min-jx-x/microprocessor-capstone/README.md

# LightQ — PDLC 단계 조광 AI 윈도우

> 시간대마다 정한 목표 밝기에 맞춰 창문 투명도를 스스로 바꾸고, 직사광이 들어오기 전에 미리 어둡게 하는 스마트 윈도우

**핵심 성과**

- **순천향대학교 캡스톤 경진대회 장려상**: 상용 컨트롤러 없이 PDLC 필름 2장, 변압기 2대, 릴레이로 3단계 조광 창문을 직접 구동해 학술제에서 실물 시연
- **AI 선제 차광**: 빛이 오르는 속도로 4초 뒤를 내다보는 결정트리(Pi에는 JSON 10KB)로, 단계를 바꿔야 하는 순간의 정확도를 규칙 48.3% → **74.9%**로 높임. 센서 잡음 3%에서도 시연 순서 200/200 성공
- **인터넷 없이 동작**: Pi 자체 핫스팟 + 휴대폰 앱, whisper.cpp 오프라인 음성 인식 + 의도 분류기(정확도 87.5%, LLM 하이브리드 93.8%)

순천향대학교 컴퓨터공학과 캡스톤디자인(마이크로프로세서) 팀 **라이트큐**의 프로젝트입니다.
PDLC(고분자 분산 액정) 조광 필름 2장을 겹쳐 투과율을 3단계로 나누고, Raspberry Pi 5가 실내 조도와 시각을 보고 단계를 자동으로 고릅니다. 필름 구동 전압(업체 안내 60~70V)에 맞춰 45V로 구동하며, 설정 하나로 100V를 더한 6단계 모드도 쓸 수 있습니다.

| 항목 | 내용 |
|---|---|
| 팀 | 강민재(팀장), 김대현, 곽재우 |
| 지도교수 | 양제파 |
| 연계 기업 | (주)유스바이오 |
| 기간 | 2026년 2학기 (완료) |
| 결과 | 순천향대학교 캡스톤 경진대회 **장려상** · 학술제에서 실물 시연 (Pi 핫스팟 + 휴대폰 앱·음성 명령) |

---

## 왜 만들었나

아침에 일어나기 힘든 이유 중 하나는 방이 너무 어둡거나, 반대로 갑자기 너무 밝아지기 때문입니다.
시중의 스마트 블라인드는 대부분 정해진 시각에 열고 닫거나, 밝기가 기준값을 넘으면 반응하는 방식이라 두 가지 한계가 있습니다.

- **목표 밝기를 따라가지 못합니다.** 열림과 닫힘 두 상태뿐이라 원하는 밝기에 맞춰 세밀하게 조절할 수 없습니다.
- **늦게 반응합니다.** 직사광선이 들어와 이미 눈이 부신 뒤에야 닫힙니다.

LightQ는 모터로 블라인드를 움직이는 대신 **필름의 투명도**를 바꿔서, 시간대별 목표 조도를 단계적으로 따라가고 밝기가 급하게 오를 때는 **미리** 어둡게 만듭니다.

## 주요 기능

- **3단계 투과율 제어**: 필름 2장 × (꺼짐 / 약 45V) 조합. `LIGHTQ_LEVELS=6`이면 100V를 더한 6단계
- **시간대별 목표 조도 추종**: 기상 준비, 아침, 주간 구간마다 목표 lux를 두고 실측 조도에 맞춰 단계 선택. 저녁·취침은 차광
- **기상 모드**: 기상 20분 전부터 목표 조도를 서서히 올려 자연광처럼 밝아짐
- **AI 선제 차광**: 최근 4초의 빛 변화로 4초 뒤 빛에 맞는 단계를 미리 고름 (결정트리)
- **오프라인 웹 대시보드**: Pi 자체 Wi-Fi 핫스팟으로 인터넷 없이 휴대폰에서 실시간 조도 확인, 단계·모드·판단 방식(규칙/AI) 변경, 기상 시각 설정
- **깜빡임 방지**: 데드밴드 + 같은 방향(어둡게/밝게) 판단 3회 연속 + 마지막 전환 후 5초 경과일 때만 전환
- **안전 장치**: 전압 전환 때 항상 전원 먼저 차단, 센서가 연속 10회 응답하지 않으면 모든 필름 전원 차단
- **하루 압축 재생**: 가상 시계로 하루를 2분에 재생해 시연
- **개인 선호 보정**: 사용자가 웹에서 직접 단계를 바꾸면 그 밝기를 선호로 배워 사용자별 목표 조도를 보정 (프로필별 저장)

## 시스템 구성

```mermaid
flowchart LR
    S[BH1750<br/>조도센서] -- I2C --> P[Raspberry Pi 5<br/>판단 · 웹서버]
    P -- GPIO --> R[릴레이 4개<br/>필름마다 두 선 차단]
    R --> F[PDLC 필름 A + B]
    T1[변압기 T1<br/>220V → 100V] --> T2[변압기 T2<br/>100V → 약 45V]
    T2 --> R
    F -. 투과광 .-> S
    U[휴대폰 웹] <-- Wi-Fi 핫스팟 --> P
```

### 필름 구동 원리

PDLC 필름은 교류 전압을 걸면 투명해지고, 전압이 없으면 빛을 흩뜨려 불투명해집니다.
상용 디밍 컨트롤러 대신 가정용 강압 변압기 2대로 두 가지 전압을 만들고, 릴레이로 필름마다 전압을 고릅니다.

- **T1**: 220V를 100V로 낮춥니다. 100V는 필름 구동 전압(60~70V)을 넘어서 필름에 직접 쓰지 않고, T2에 전기를 주는 데만 씁니다.
- **T2**: T1의 100V 출력을 다시 낮춰 약 45V를 만듭니다. 필름을 켜는 전압입니다.
- 필름마다 전원 릴레이 2개(PA·PA2, PB·PB2)를 같은 GPIO에 연결해 **두 선을 모두 끊습니다.** 꺼진 필름에는 전압이 남지 않습니다.

| 단계 | 필름 A | 필름 B | 상태 |
|:-:|:-:|:-:|---|
| 0 | 꺼짐 | 꺼짐 | 가장 어두움 (취침·저녁) |
| 1 | 45V | 꺼짐 | |
| 2 | 45V | 45V | 가장 밝음 |

> 실측값(`pi/data/lut.json`)을 넣으면 프로그램이 단계 순서를 밝기 순으로 자동 정렬합니다. 6단계 모드(`LIGHTQ_LEVELS=6`)에서는 100V/꺼짐, 100V/45V, 100V/100V가 추가되고, 필름마다 선택 릴레이 2개(SA1·SA2, SB1·SB2)로 45V와 100V를 고릅니다.

## 소프트웨어 구조

```mermaid
flowchart TD
    subgraph DEV["장치 계층 (같은 인터페이스)"]
        D1[실제: BH1750 · GPIO 릴레이]
        D2[가짜: SimSensor · SimRelays<br/>+ 가상 시계 · 바깥 빛]
    end
    L[제어 루프 loop.py<br/>1초 주기]
    J1[규칙 판단 decide.py]
    J2[AI 판단 policy.py<br/>결정트리 JSON]
    ST[안정화 · 안전 전환]
    DB[(SQLite 로그)]
    W[Flask 웹 app.py<br/>대시보드 · API]
    DEV --> L
    L --> J1 & J2
    J1 & J2 --> ST --> DEV
    L --> DB
    W <-- 명령 / 상태 --> L
```

- 센서·릴레이의 함수 모양을 먼저 정해, 노트북에서는 가짜 장치로, Pi에서는 실제 장치로 **같은 제어 코드**를 돌립니다.
- 웹은 명령만 보내고 릴레이는 제어 루프 한 곳에서만 움직입니다 (스레드 간 lock).
- 규칙과 AI는 같은 모양의 판단 함수라 웹에서 바로 바꿔 끼울 수 있습니다.

## 제어 흐름

```mermaid
flowchart TD
    A[조도 · 시각 측정<br/>1초 주기] --> F[중앙값 평활<br/>최근 5회, 같은 단계만]
    F --> B[목표 단계 계산<br/>AI 또는 규칙]
    B --> C{전환 조건?<br/>목표 ≠ 현재<br/>같은 방향 3회 연속 · 최소 5초 간격}
    C -- 아니오 --> A
    C -- 예 --> D[전원 릴레이 OFF]
    D --> E[전압 선택 릴레이 변경]
    E --> G[전원 릴레이 ON]
    G --> A
```

수동 버튼·음성 명령은 평활·전환 조건을 거치지 않고 바로 적용합니다.

전압을 바꿀 때는 항상 **전원 끄기 → 전압 선택 → 전원 켜기** 순서를 지킵니다. 필름에 전압이 걸린 상태로 전압 단자가 바뀌지 않게 하기 위해서입니다. 이 순서는 가능한 모든 단계 전환(3단계 9가지, 6단계 36가지)을 자동 테스트로 검증합니다.

### 규칙 판단

1. 입사광 추정: `실측 조도 / 현재 단계 투과율` (센서가 필름 안쪽에 있어 바깥 빛을 역산)
2. 필요 투과율: `목표 조도 / 입사광`
3. 필요 투과율에 가장 가까운 단계를 고르고, 현재 단계와 차이가 작으면(데드밴드 0.05) 유지

## AI 선제 차광

규칙 판단은 **지금** 빛만 보기 때문에 직사광이 다 올라온 뒤에야 반응합니다. AI는 빛이 오르는 속도를 보고 **4초 뒤 빛**에 맞는 단계를 미리 고릅니다.

| 항목 | 내용 |
|---|---|
| 입력 특징 (6개) | 필요 투과율(log), 최근 3구간 입사광 변화율, 현재 단계, 목표 조도 |
| 정답 | 시뮬레이터가 아는 4초 뒤 실제 입사광에 맞는 단계 |
| 학습 데이터 | 300일, 약 10만 행. 기상청 ASOS 일사량 곡선(서산·홍성·보령) + 합성 구름·직사광, 배속·기상 시각 무작위. 학습용 날은 센서 잡음 2%를 더한 복사본을 하나씩 추가(잡음 증강) |
| 입력 | 제어 루프와 같은 중앙값 평활(최근 5회)을 거친 조도 |
| 모델 | 결정트리 (깊이 8, 잎 221개) + 출력 데드밴드 (밝게 가자고 할 때 차이가 작으면 현재 단계 유지) |
| 검증 | 날짜 단위로 5일 중 1일을 떼어 처음 보는 날로 시험 |
| 실행 | 학습은 노트북(scikit-learn), Pi는 트리 구조 JSON(약 10KB)만 읽어 if문으로 추론 |

아래 수치는 11/1 센서 고정 후 실측 투과율(`pi/data/lut.json`), 주간 목표 320 lux, 중앙값 평활·잡음 증강을 넣어 다시 학습한 결과입니다. 시험용 날은 증강하지 않았습니다.

| 모델 시험 (정답 = 4초 뒤 빛 기준, 3단계, 실측 투과율) | 규칙 | AI |
|---|---|---|
| **바꿔야 할 때** (정답이 지금 단계와 다른 순간) | 48.3% | **74.9%** |
| 빛이 오르는 구간 | 81.6% | 93.4% |
| 전체 | 89.3% | 92.4% |

정답은 0단계 65%, 1단계 12%, 2단계 23%이고, "지금 단계 유지"만 해도 전체 정확도가 81.7%입니다. 그래서 단계를 바꿔야 하는 순간만 본 정확도를 주 지표로 씁니다. 중앙값 평활은 입력을 약 2초 늦게 만들어 4초 뒤 빛을 맞히는 정확도를 조금 낮추지만, 잡음에 흔들리지 않게 합니다([정량 평가](#정량-평가) 3).

### 왜 결정트리인가 (`python -m pi.ai.compare_models`)

같은 데이터·같은 시험 날짜로 다른 모델과 비교했습니다. 결과는 `pi/data/ai_report.json`에 저장되고, 웹 대시보드의 **AI 설명** 페이지(`/ai`)에서 그래프와 함께 보입니다.

| 모델 (실측 투과율) | 바꿔야 할 때 | Pi에 올리는 방법 |
|---|---|---|
| 규칙 (기준선) | 48.3% | - |
| **결정트리 (깊이 8, 현재)** | **74.9%** | JSON 10KB, if문 몇 번 |
| 로지스틱 회귀 | 70.7% | 가중치 몇 개 |
| 랜덤포레스트 100그루 | 76.7% | 16MB, scikit-learn 필요 |
| 그래디언트 부스팅 | 76.3% | 391KB, scikit-learn 필요 |
| 신경망 (MLP 32×32) | 76.3% | 행렬 곱 구현 필요 |

- **복잡한 모델과 차이가 2%p 안**(76.3~76.7%)인데, 결정트리는 Pi에 파일 하나로 올라가고 판단 근거(지나온 질문 경로)를 그대로 보여 줄 수 있습니다.
- **깊이 8**: 깊이 8에서 74.9%, 16까지 깊게 해도 75.0%로 거의 같은데 잎(규칙 수)은 221 → 1131개로 늘어납니다.
- **특징**: 빛 변화율 3개를 빼면 74.9% → 64.0%로 떨어집니다. AI가 규칙보다 나은 이유가 "빛이 오르는 속도"라는 뜻입니다.
- **4초 앞**: 안정화가 같은 판단 3번 연속을 요구해서 반응이 늦어지는데, 4초 앞을 보면 이 지연이 메워집니다. 4초는 **가정값 시뮬레이션**(실측 전)에서 직사광 눈부심이 1초 앞 1.8초, 4초 앞 0.5초, 8초 앞 10.8초로 가장 적어 정했습니다(규칙 2.1초). 실측 투과율에서는 직사광 장면에서 규칙·AI 모두 처음부터 0단계라 이 비교로는 차이가 나지 않습니다([정량 평가](#정량-평가) 4).

웹의 AI 설명 페이지에는 **지금 AI가 왜 이 단계를 골랐는지**(입력 6개, 트리가 지나온 질문, 규칙 답, 안정화 진행)도 1초마다 보여 줍니다.

일사량 환산은 `tools/convert_kma_radiation.py`를 따릅니다. 기상청 일사량(1시간 누적, MJ/m²)을 평균 일사강도(W/m²)로 바꾸고 자연광 발광효율 약 116 lm/W를 곱합니다. 학습에는 곡선의 모양만 쓰고, 크기는 시연 조명 수준으로 맞춥니다.

## 개인 선호 보정

AI(결정트리)는 **목표에 어떻게 빨리 맞출지**를 정하는 공통 모델이고, 선호 보정은 **목표를 얼마로 할지**를 사람마다 맞춥니다.

| 항목 | 내용 |
|---|---|
| 학습 신호 | 사용자가 단계를 직접 바꾼 뒤 3초 동안 잰 실내 조도(중앙값) = 그 사람이 원하는 밝기 |
| 학습 방식 | 시간대(아침·주간)별 보정값 ← 0.7 × 보정값 + 0.3 × (선호 조도 / 기본 목표 − 1), ±30% 제한 |
| 사용자 | 웹에서 프로필 선택·추가, `pi/data/preferences.json`에 저장 (재부팅해도 유지) |
| 사전 학습 | 필요 없음. 사용하면서 배우는 온라인 학습 |

선호가 다른 가상 사용자 3명(주간 선호 650 / 520 / 380 lux)을 날씨 10가지로 2주씩 돌려 검증했습니다 (`python -m pi.ai.eval_preference`). 아래 결과는 **6단계 구성 기준**입니다.

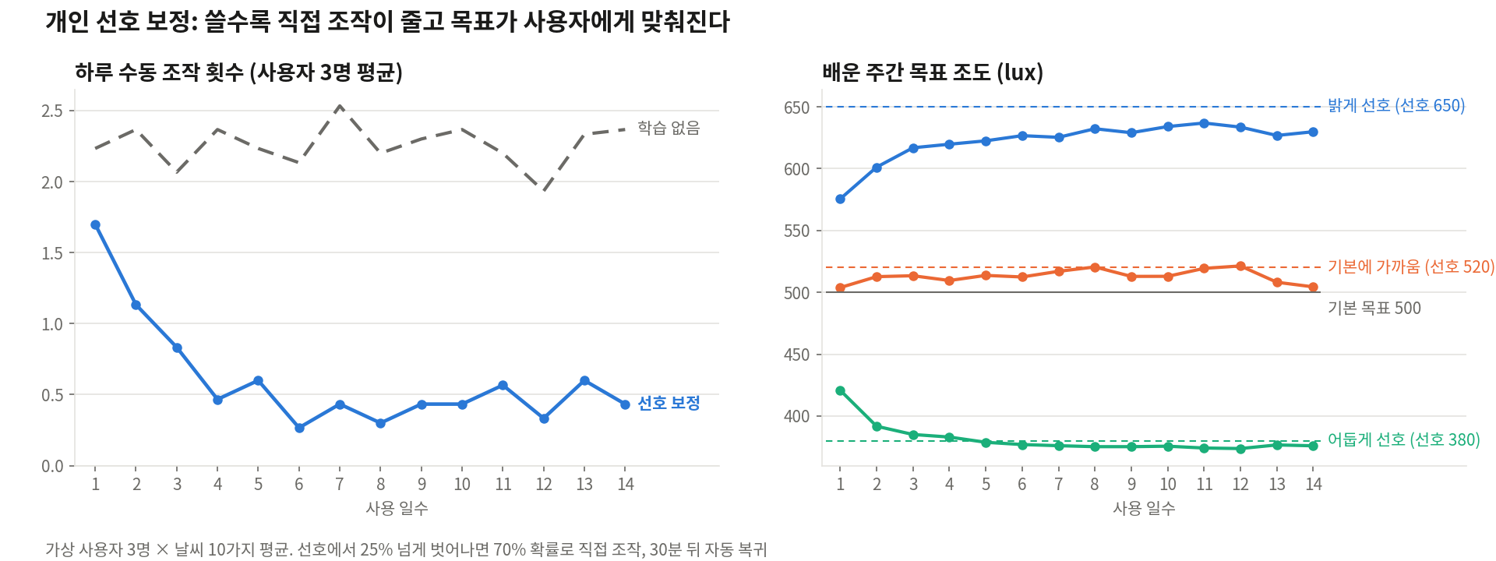
[picture p1: docs/archive/six-level/preference_learning.png]
선호 보정 (6단계)


| 지표 (마지막 7일 평균, 6단계) | 학습 없음 | 선호 보정 |
|---|---|---|
| 하루 수동 조작 횟수 (3명 평균) | 2.24회 | **0.44회** |
| 배운 주간 목표 (밝게 / 기본 근처 / 어둡게 선호) | 500 / 500 / 500 | **630 / 504 / 376** |

- 선호가 기본값과 비슷한 사용자는 원래 조작이 적어 차이가 거의 없습니다 (0.36 → 0.49회, 오차 범위).
- 가상 사용자 행동(25% 넘게 벗어나면 70% 확률로 조작)은 가정입니다.
- **3단계에서는 같은 시뮬레이션으로 효과가 나오지 않습니다.** 가장 밝은 단계(45V/45V)의 가정 투과율이 낮아 한낮에도 실내가 약 330~490 lux로 주간 목표(500 lux)에 못 미치고, 가상 사용자가 더 밝게 하고 싶어도 이미 가장 밝은 단계라 조작할 일이 없습니다(수동 조작 0회). (가정값 기준. 11/1 실측 투과율·주간 목표 320 lux로는 아직 다시 검증하지 않았습니다.)

## 음성 명령 (하이브리드)

휴대폰 앱의 음성 탭에서 "너무 밝아", "2단계로", "자동으로" 같은 문장으로 단계를 바꿉니다. 판단은 Pi가 하고, 웹 단계 버튼과 같은 경로(`set_manual`)로 적용됩니다.

휴대폰으로 `/`에 들어오면 앱 화면 `/app#home`으로 넘어갑니다(`/?full=1`이면 그 탭에서는 계속 대시보드). 휴대폰 판별은 "터치가 주 입력이고 화면 짧은 변이 700px 이하"라서 폰을 가로로 돌려도 앱이고, 노트북은 창을 좁혀도, 아이패드는 대시보드입니다. **앱과 음성 명령은 휴대폰 전용**이라 노트북 대시보드에는 음성 카드와 앱 링크가 없고, 노트북으로 `/app`·`/voice`를 열면 대시보드로 돌아갑니다(노트북에서 미리 보려면 크롬 F12 → 기기 모드에서 iPhone 선택). 아래 탭 바로 홈 / 음성(가운데 원형 마이크) / 설정을 오가며, 탭은 주소 해시(`#home` 등)로 바꿔 페이지를 다시 읽지 않습니다. 예전 주소 `/voice`는 `/app#voice`로 넘어갑니다. 녹음 코드는 `pi/static/voice-rec.js`.

- 홈: 실내 조도, 단계마다 뿌연 정도가 다른 창문 그림, 0/1/2 단계 버튼, 자동 제어 스위치, "AI가 조절 중 · 목표 320 lux". 수동일 때 "자동으로 돌아가기"
- 음성: 누르고 말하기, 예시 문장 4개, 접힌 "글자로 입력"
- 설정: 기상 시간, 선호 밝기(사용자 선택·추가·초기화), 수동 조절 학습, 음성도 학습
- 시연 잠금: `LIGHTQ_DEMO_LOCK=1`로 서버를 켜면 선호 밝기(사용자 선택·추가·초기화)와 학습 스위치 두 개를 바꾸는 API가 403("시연 중에는 잠겨 있어요")을 돌려줍니다. 기상 시간과 단계·자동 전환은 그대로 됩니다. 앱 설정 탭은 해당 조작을 끄고 안내를 띄우며, 대시보드는 잠금 상태만 표시합니다(해제는 환경변수를 빼고 다시 시작)

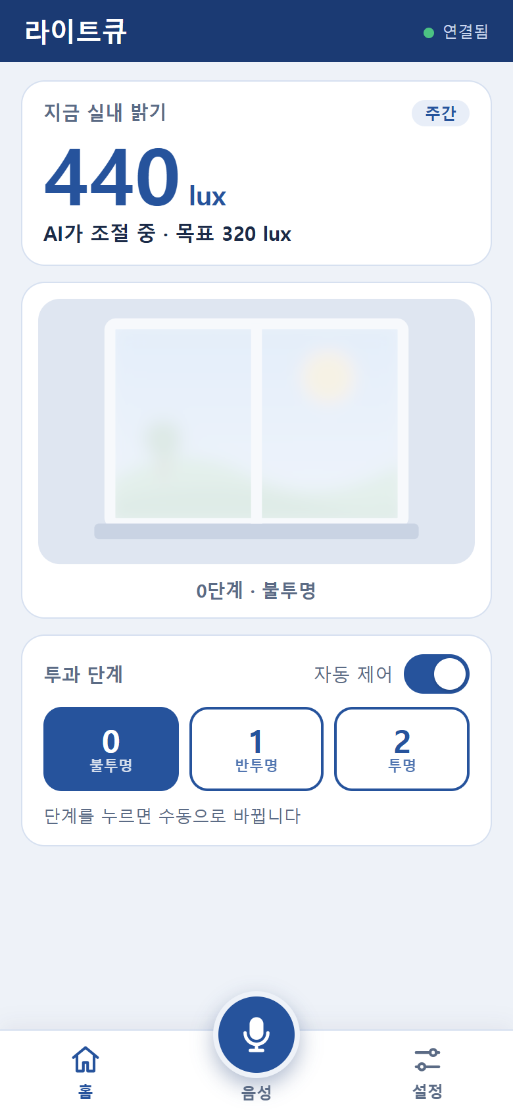
[picture p2: docs/images/app-home.png]
앱 홈 탭
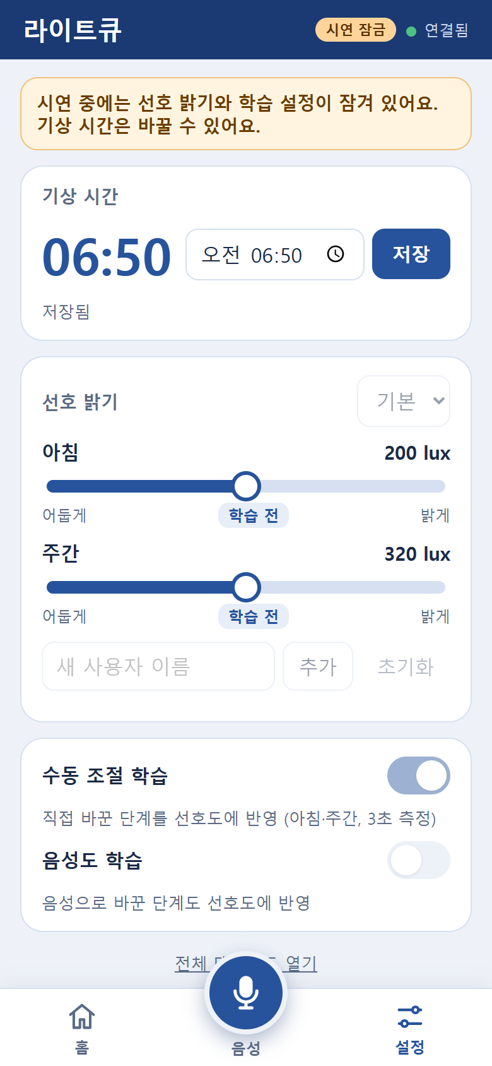
[picture p3: docs/images/app-settings-locked.png]
앱 설정 탭 (시연 잠금)
 앱 음성 탭 앱 설정 탭 

| 입력 | 방법 |
|---|---|
| 휴대폰 (권장) | 앱 음성 탭의 마이크 버튼(누르고 있는 동안 녹음) → Pi의 **whisper.cpp가 인터넷 없이** 글자로 변환. 브라우저 규칙상 HTTPS에서만 마이크가 열려서 `https://10.42.0.1:5443`(자체 서명 인증서, 처음 한 번 경고 → 계속)으로 접속 |
| 휴대폰 (예비) | 맨 아래 "글자로 입력"을 눌러 펼친 입력칸 + 키보드 마이크(받아쓰기). http(`10.42.0.1:5000`)에서도 되고 설정 없이 여러 대 동시 사용 가능. http로 들어오면 마이크용 HTTPS 주소를 안내 |
| whisper 서버가 없을 때 | 마이크 버튼은 브라우저 음성 인식(Web Speech, 대개 인터넷 필요)으로 동작 |

```
음성 → (웹에서 16kHz WAV로 녹음) → Pi whisper.cpp 서버(127.0.0.1:8178, base 모델) → 글자 → 아래 의도 판단
```

- 설치: `bash deploy/setup_whisper.sh` (Pi, 인터넷 필요한 건 설치 때 한 번), 인증서: `bash deploy/make_cert.sh`
- 소리가 거의 없으면 보내지 않고, Whisper가 지어내는 `[음악]` 같은 표기는 지움. 잡음에 Whisper가 인식 힌트(프롬프트)를 그대로 읊으면 "잘 안 들렸어요"로 처리
- 인식 힌트는 문장 없이 어휘만 둠("라이트큐 창문 밝기 단계 …"). 문장으로 두었을 때 노래만 틀어도 "잘 거야.", "1단계." 같은 힌트 문장을 지어내 실제로 단계가 바뀌었음. 어휘만 둔 뒤에도 노래에서 "사생활"(privacy 0.82)을 지어내 그 단어도 뺌
- 잡음 판정: whisper 응답(`verbose_json`)의 구간별 말 없음 확률 > 0.6 또는 평균 logprob < −0.4이면 그 구간을 버림. 기준은 `LIGHTQ_STT_MAX_NO_SPEECH`, `LIGHTQ_STT_MIN_LOGPROB`로 바꿈
  - Pi 재측정: 실제 명령은 logprob −0.05 ~ −0.27, 노래에서 지어낸 "사생활"은 −0.436 → 기준을 −1.0에서 −0.4로 올림. 말 없음 확률은 모든 녹음에서 0.0이라 그 기준으로는 걸러지지 않음
- 녹음은 최대 8초. 8초가 지나면 자동으로 보내고 "8초가 지나 보냈어요"로 알림
- whisper.cpp(base 모델) 인식 시간·정확도: Pi에서 따로 재지 못했습니다 ([한계와 향후 과제](#한계와-향후-과제))
- 녹음 파일은 기본으로 저장하지 않음. 정확도 확인 때만 `LIGHTQ_VOICE_KEEP=20`으로 최근 20개를 `pi/data/voice_audio/`에 남김(`python -m pi.voice.stt_check 파일.wav`)

```
문장 → ① 의도 분류기 (Pi, 오프라인, 약 0.1ms)
          ├ 확신도 ≥ 0.6 → 바로 적용
          └ 낮음 / 모름 → ② LLM (Gemini, 키·인터넷 있을 때)
                              ├ JSON 검사 통과 → 적용 ("영화 볼 거야" → 0단계 같은 상황형 문장)
                              └ 실패 / 없음 → 확신도 ≥ 0.35면 분류기 답, 아니면 "다시 말해 주세요"
```

- 분류기: 글자 1~3개 묶음 TF-IDF + 로지스틱 회귀. 예문 `pi/data/voice_intents.csv`, 학습 `python -m pi.voice.train` (노트북) → `pi/data/intent_model.json`
- 의도 8가지: 어둡게(−1), 밝게(+1), 단계 지정, 다 가리기(0), 가장 밝게, 자동, 상태 질문, 관계없음
- 안전: LLM 답은 동작·단계 범위를 코드에서 다시 검사, 5초 제한, 분당 10회 제한, 사용량 초과(429) 때 1분 쉬기
- 여러 기기: 명령을 하나씩 처리하고 단계를 바꾸는 명령 사이 2초 간격. 기록에 기기 이름을 자동으로 표시(접속 주소마다 번호: "아이폰 1", "갤럭시 2", "노트북 3". 서버를 다시 켜면 1부터)
- 음성 명령은 기본적으로 선호 학습에 쓰지 않음(관람객 명령이 섞이지 않게). 대시보드 "개인 맞춤 설정"이나 앱 설정 탭의 "음성도 학습"으로 켬

| 지표 (`python -m pi.voice.evaluate`, 학습에 쓰지 않은 48문장) | 결과 |
|---|---|
| 분류기만 (LLM 없음) | **정확도 87.5%** (분류기 답 그대로, 48문장 중 6개 틀림, `pi/data/voice_report.json`), 평균 0.1ms. 확신도 기준까지 적용하면(`evaluate`, 기준 미달은 '모름'으로 틀림 처리) 85.4%. 틀린 7개 중 3개는 '모름'으로 아무것도 바꾸지 않음 |
| 하이브리드 (분류기 + gemini-3.1-flash-lite) | **정확도 93.8%** (예문 보강 전 측정). LLM 호출 15회 중 13회 성공(약 0.8~1초), 2회는 3초 시간 초과로 분류기 답 사용 |
| 상황형 예문 37개 보강 후 (인터넷 없이) | 시험 48문장은 85.4% 그대로, 학습에 없는 상황형 문장("곧 잘 거야", "이제 영화 시작할게" 등) 10개 중 **6개**를 분류기만으로 처리 (보강 전 0개) |
| 남은 틀림 3개 | '좀 덜 환하게', '햇살 좀 들여보내 줘', '지금 몇 시지': 분류기가 높은 확신으로 틀려 LLM까지 가지 않음 (예문 보강으로 고칠 수 있는 유형, 향후 과제) |

예문에 없는 상황형 문장은 LLM이 처리합니다: "영화 볼 거야" → 0단계(가리기), "책 읽을 거야" → 가장 밝게.

## 정량 평가

### 1. 실물 실측 (11/1, 3단계, 센서 위치 고정 후)

스탠드-필름 20cm대, 필름-센서 20cm대 일직선 고정, 잡광 172 lux. 상대 투과율은 잡광을 뺀 값을 2단계로 나눈 값입니다.

| 스탠드 밝기 | 0단계 (꺼짐/꺼짐) | 1단계 (45V/꺼짐) | 2단계 (45V/45V) | 상대 투과율 (0/1/2단계) |
|---|---|---|---|---|
| 2 | 202.5 lux | 213.3 lux | 234.2 lux | 0.490 / 0.664 / 1.0 |
| 5 | 245.8 lux | 261.7 lux | 291.7 lux | 0.617 / 0.749 / 1.0 |
| 7 | 278.3 lux | 296.7 lux | 335.8 lux | 0.649 / 0.761 / 1.0 |
| 10 | 341.7 lux | 366.7 lux | 421.7 lux | **0.6796 / 0.7797 / 1.0** (기준) |

- **필름은 최대 약 32%만 빛을 줄입니다.** 가장 뿌연 0단계도 가장 투명한 2단계 빛의 약 68%가 통과합니다 (기준인 스탠드 10).
- `pi/data/lut.json`은 빛이 가장 센 스탠드 10 값으로 만들었습니다 (`python -m pi.calib --lux 341.7 366.7 421.7 --ambient 172 --lamp-step 10`).
- 스탠드 2는 빛이 약해 잡광을 빼면 남는 값이 31~62 lux뿐이라, 몇 lux의 측정 오차에도 비율이 크게 흔들립니다 (0단계 0.490).
- 센서 고정 전 잡음 ±1.3% → 고정 후 ±0.15% (스탠드 7에서 280.0~280.8 lux).

### 2. 시연 순서 (스탠드 2 → 10 → 7 → 2)

주간 목표(`TARGET_DAY_LUX`)는 320 lux입니다. 판단 규칙을 위 실측 lux로 수렴할 때까지 반복 적용하면, 목표 310~330에서 시작 단계(0/1/2)와 관계없이 아래처럼 됩니다 (305 이하·335 이상은 깨짐). 규칙은 잡음 표준편차 3%에서도 200/200 성공했습니다. 예전 기본값 500이면 스탠드 10에서도 2단계(가장 투명)를 골라 뿌예지지 않습니다.

| 순서 | 스탠드 | 수렴 단계 | 창문 |
|---|---|---|---|
| 1 | 2 | 2단계 (45V/45V) | 투명 |
| 2 | 10 | 0단계 (꺼짐/꺼짐) | 뿌옇게 |
| 3 | 7 | 1단계 (45V/꺼짐) | 중간 |
| 4 | 2 | 2단계 (45V/45V) | 다시 투명 |

- 스탠드를 바꿔도 창문 단계는 이전 상태에서 이어집니다. 스탠드 7은 0단계에서 들어올 때 1단계로 가고, 2단계에서 바로 들어오면 데드밴드 때문에 2단계에 머뭅니다. 그래서 10 다음에 7을 켭니다.
- 저녁(18시 이후)에는 0단계 고정이라, 시각을 주간으로 고정해 실행합니다: `python -m pi.app --real --start 11:00 --speed 0`
- 현장 잡광이 달라 순서가 안 맞으면 주간 목표만 `LIGHTQ_TARGET_DAY_LUX`로 바꿉니다 ([deploy/README.md](deploy/README.md) 9장).
- 검증 테스트: `pi/tests/test_decide.py` (스탠드 2·5 → 2단계, 10 → 0단계, 시연 순서 → 2, 0, 1, 2단계)

### 3. 센서 잡음 실험 (규칙 대 AI)

시연 순서가 센서 잡음에 흔들리는지 실제 제어 루프로 확인했습니다.

- 방법 (`python -m pi.ai.noise_check`): 센서 값 = 위 실측 lux × (1 + 정규분포 잡음). 스탠드마다 60초, 제어 루프 그대로(평활 → 판단 → 같은 방향 3회 연속 → 전환 간격 5초), 시각은 12:00 고정. 스탠드별 마지막 단계가 2, 0, 1, 2면 성공.

**최종 결과** (센서 고정 후 실측값, 최종 설정, 200회씩)

| 잡음 (표준편차) | 규칙 성공 | AI 성공 |
|---|---|---|
| 0.15% (고정 후 실측) | 200 / 200 | 200 / 200 |
| 1% | 200 / 200 | 200 / 200 |
| 2% | 200 / 200 | 200 / 200 |
| 3% | 200 / 200 | 200 / 200 |

**개선 과정** (센서 고정 전 실측값으로 실험, 50회씩 AI 오판 1% / 2%. 규칙은 모든 단계에서 0 / 0)

| 단계 | 내용 | AI 오판 |
|---|---|---|
| 개선 전 | | 9 / 11 |
| + 중앙값 평활 | 최근 5회 측정의 중앙값으로 판단 (`SENSOR_MEDIAN_N = 5`, 규칙·AI 공통). 단계를 바꾸면 그 단계에서 잰 값만 씀 | 6 / 12 |
| + 잡음 증강 학습 | 학습용 날마다 센서 값에 2% 잡음을 더하고 같은 평활을 거친 복사본 추가 | 4 / 13 |
| + AI 출력 데드밴드 | AI가 **밝게** 가자고 할 때, 그 단계가 현재 단계보다 (지금 필요 투과율 기준) `DEADBAND_T`(0.05) 넘게 낫지 않으면 유지 (`AI_DEADBAND = "brighter"`) | **0 / 0** |

- AI의 오판은 모두 스탠드 7(0단계에서 진입)이었습니다. 스탠드를 10 → 7로 바꾸면 조도가 약 20% 떨어지는데, 트리가 이를 "빛이 계속 줄어드는 중"으로 보고 1단계 대신 2단계를 고르고, 2단계에 오르면 그대로 머뭅니다.
- 오판을 막는 것은 **데드밴드**입니다. 센서 고정 후 값에서 데드밴드를 끄면 AI는 잡음 0.15%에서도 200회 중 99회 오판합니다 (스탠드 7의 필요 투과율 0.781이 1단계 0.780과 거의 같아, 작은 잡음에도 트리 답이 2단계로 넘어감). 그래서 시연 순서에서 AI의 "밝게" 판단은 사실상 데드밴드가 걸러 줍니다.
- 데드밴드를 **밝게 가는 쪽에만** 건 이유: 양쪽에 걸면(`"both"`) 직사광이 오를 때 미리 어둡게 하는 선제 차광까지 막힙니다. 40일 시뮬레이션 반응 지연이 밝게 쪽만 4.0초, 양쪽 5.9초로 규칙(5.3초)보다도 늦었습니다.
- 디바운스(`SWITCH_CONFIRM_N = 3`)는 원래 있던 안정화 조건입니다(현재와 다른 단계를 같은 방향으로 3회 연속 골라야 전환, 전환 사이 5초). 수동 버튼·음성 명령은 바로 적용합니다.
- **반응 시간** (제어 주기 1초, 잡음 없음): 스탠드를 바꾼 뒤 한 단계 바뀌는 데 2초 → **4초**(평활 +2초: 5개 중 3개가 새 값이 돼야 중앙값이 바뀜, 디바운스 2초는 원래 있음). 두 단계(스탠드 10, 2 → 1 → 0단계)는 전환 간격 5초가 더해져 7초 → **9초**.
- **시연 기본 판단은 AI**입니다. 문제가 생기면 웹에서 바로 규칙으로 바꾸고, 재시작해도 규칙으로 두려면 `LIGHTQ_POLICY=rule` ([deploy/README.md](deploy/README.md) 9장).

### 4. 실측 투과율 시뮬레이션 (규칙 대 AI)

같은 날씨·같은 센서 잡음으로 규칙과 AI를 각각 돌려 비교합니다. 센서 고정 후 실측 투과율(`lut.json`), 주간 목표 320 lux, 중앙값 평활·AI 출력 데드밴드를 넣은 최종 설정 기준이고, 그래프는 `python -m pi.ai.plot_compare`로 다시 만들 수 있습니다.

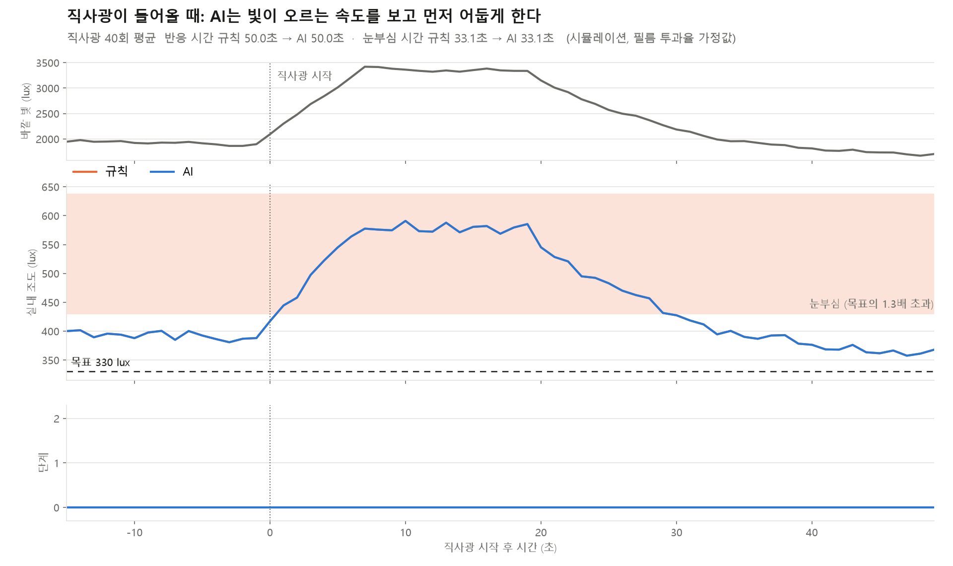
[picture p4: docs/images/compare_burst.png]
직사광 비교


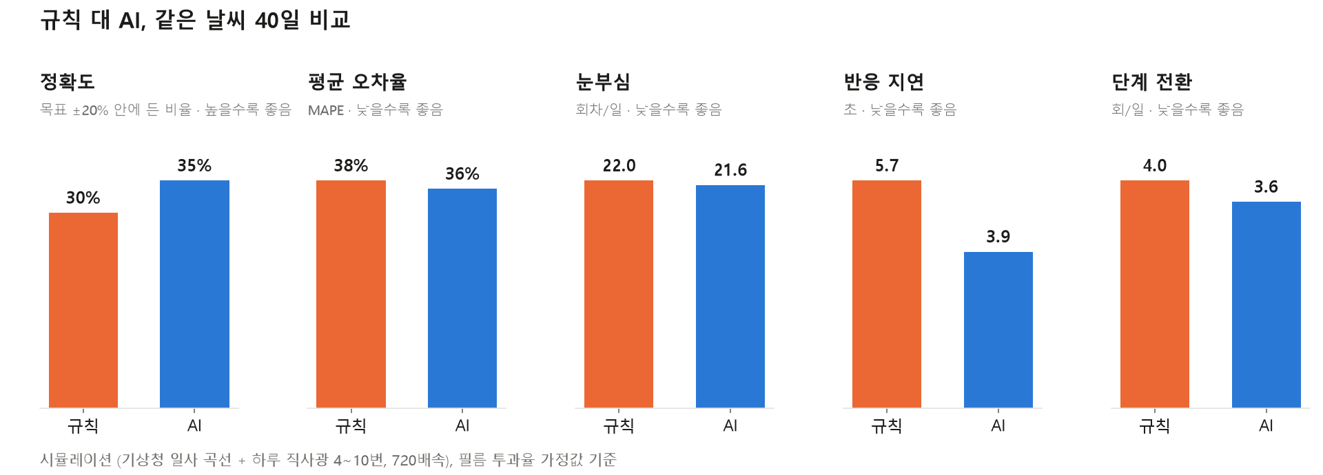
[picture p5: docs/images/compare_metrics.png]
지표 비교


| 지표 | 정의 | 규칙 | AI |
|---|---|---|---|
| 직사광 반응 (1배속, 40회 평균) | 직사광 시작부터 어둡게 바꿀 때까지 | 50초 (반응 없음) | 50초 (반응 없음) |
| 직사광 눈부심 (1배속, 40회 평균) | 목표의 1.3배를 넘은 시간 | 49.1초 | 49.1초 |
| 정확도 (하루 단위, 40일) | 실내 조도가 목표 ±20% 안에 든 비율 | 27.3% | **28.1%** |
| MAPE | 목표 대비 평균 절대 오차율 | 48.5% | **47.7%** |
| 눈부심 | 목표의 1.3배를 넘은 회차/일 | 29.7 | **29.2** |
| 전환 횟수 | 단계가 바뀐 횟수/일 | 3.2 | **1.6** |
| 반응 지연 | 직사광 시작부터 어둡게 바꿀 때까지 | 5.3초 | **4.0초** |

- **직사광 장면에서는 차이가 없습니다.** 필름이 최대 약 32%만 빛을 줄여서, 시뮬레이터의 한낮 바깥 빛(약 2000 lux)이면 0단계로도 목표 320 lux를 넘습니다. 규칙과 AI 모두 직사광이 오기 전부터 0단계라 더 어둡게 할 단계가 없습니다 (그래프의 50초 = 장면 끝까지 반응 없음).
- 하루 단위에서 AI는 반응이 1.3초 빠르고 전환이 하루 절반입니다. 정확도·눈부심 차이는 작습니다(데드밴드를 끄면 정확도 30.6%, 밝게 가는 전환을 줄인 만큼 낮아짐). 눈부심이 둘 다 하루 약 29회인 것은 차광 폭이 좁은 필름의 한계라 판단 방식으로는 줄일 수 없습니다.
- 720배속에서는 1회(1초)가 가상 12분이라 하루 곡선 자체의 변화가 커서, 직사광만 따로 본 1배속과 결과가 다릅니다.
- 로그는 `tools/metrics.py`가 읽는 형식(`ms, hour, lux, level`)으로도 내보냅니다.

### 5. 가정값 시뮬레이션 (실측 전, 참고용)

> 실측 전 **가정 투과율**(0.44 / 0.67 / 1.0, 가장 뿌연 단계에서 56% 감광)과 주간 목표 500 lux로 돌린 결과입니다. 실물 필름과 맞지 않아 결론에는 쓰지 않습니다. 위 그래프와는 다른 조건입니다.

| 지표 (가정값) | 규칙 | AI |
|---|---|---|
| 직사광 시작부터 어둡게 바꿀 때까지 (1배속) | 8.3초 | 6.5초 |
| 직사광 눈부심 시간 (1배속) | 2.1초 | 0.5초 |
| 하루 정확도 / MAPE | 34.6% / 39.9% | 38.3% / 39.1% |
| 하루 눈부심 / 전환 / 반응 지연 | 1.9회 / 3.4회 / 9.4초 | 0.7회 / 3.5회 / 6.9초 |

- 필름이 더 많이 가릴 수 있다면(가정값) AI의 선제 차광이 눈부심을 약 1/3로 줄였습니다. 실물에서 같은 효과를 보려면 차광 폭이 더 큰 필름이나 필름 추가가 필요합니다 (100V 구동은 필름 정격 60~70V를 넘어 쓰지 않음).
- 원래 설계였던 6단계 결과는 [트러블슈팅 기록](docs/troubleshooting-6-to-3-levels.md#6-6단계-시뮬레이션-결과-보관)에 있습니다.

## 실행 방법

레포 최상위 폴더에서 실행합니다. (Python 3.11)

```bash
pip install -r pi/requirements.txt            # flask, pytest (Pi에서는 센서·GPIO 라이브러리 포함)

python -m pi.app --speed 720 --start 06:30    # 노트북: 가짜 장치로 하루를 2분에 재생
python -m pi.app --real                       # Pi 5: 실제 센서·릴레이
python -m pi.app --real --start 11:00 --speed 0   # 실물 시연: 시각을 주간에 고정
```

브라우저에서 `http://localhost:5000` (Pi 핫스팟에서는 Pi 주소의 5000번 포트). AI 설명 페이지는 `/ai`

```bash
python -m pytest pi/tests -q                  # 자동 테스트 163개 (+ 실제 드라이버 테스트 6개, gpiozero가 있으면 자동 실행)

pip install -r pi/requirements-ai.txt         # AI 학습용 (노트북에서만)
python -m pi.ai.retrain                       # 데이터 생성 → 학습 → 규칙 대 AI 비교 → 모델 선택 근거 실험
python -m pi.ai.plot_compare                  # 비교 그래프 (docs/images, 현재 단계 구성 기준)
python -m pi.ai.eval_preference               # 개인 선호 보정 검증 (가상 사용자 3명)
python -m pi.ai.compare_models                # 모델 비교·깊이·특징·예측 시간 실험 (웹 /ai 페이지)
```

### Raspberry Pi 5 설치

Pi를 받은 날의 OS 설치부터 센서·릴레이 시험, 핫스팟, 부팅 시 자동 실행까지 순서는 [deploy/README.md](deploy/README.md)에 있습니다.

```bash
bash deploy/setup_pi.sh                            # 패키지·I2C·가상환경·테스트
.venv/bin/python -m pi.tools.check_sensor          # 조도센서 확인
.venv/bin/python -m pi.tools.check_relays --each   # 릴레이 확인 (교류 연결 없이)
```

### 실측값 반영

필름 조립 후 같은 광원에서 0~2단계 실내 조도와 광원을 끈 잡광을 잰 뒤:

```bash
python -m pi.calib --lux 120 260 410 --ambient 5                # pi/data/lut.json 생성
python -m pi.ai.retrain                                         # 실측 기준으로 AI 다시 학습
```

11/1 센서 고정 후 실측에 쓴 명령: `python -m pi.calib --lux 341.7 366.7 421.7 --ambient 172 --lamp-step 10 --note "측정 조건"`. 결과와 시연 순서는 [정량 평가](#정량-평가) 1·2에 있습니다.

값 순서는 기본 단계표(꺼짐/꺼짐, 45V/꺼짐, 45V/45V)입니다. 6단계 모드는 `LIGHTQ_LEVELS=6`을 붙이고 값 6개(뒤에 100V/꺼짐, 100V/45V, 100V/100V)를 넣습니다. 단계 순서 정렬, 판단 규칙, 시뮬레이터, AI 학습이 모두 실측값으로 바뀝니다. 투과율표가 바뀌었는데 재학습하지 않으면 웹에 경고가 뜹니다.

## 기술 스택

- **하드웨어**: Raspberry Pi 5, BH1750(GY-302), 1채널 릴레이 모듈 4개(6단계 모드 6개), 가정용 강압 변압기 2대, PDLC 조광 필름 2장
- **소프트웨어**: Python, Flask, SQLite, gpiozero · lgpio, smbus2, NumPy, scikit-learn · matplotlib(노트북 학습·그래프만), pytest
- **프런트엔드**: HTML · CSS · JavaScript, 외부 라이브러리 없이 SVG 그래프 (핫스팟에 인터넷이 없으므로)
- **네트워크**: NetworkManager 핫스팟 (외부 인터넷 불필요)

## 폴더 구조

```
.
├── pi/                 # Raspberry Pi 5 실행 코드
│   ├── app.py          # Flask 웹 서버와 API
│   ├── config.py       # 모든 설정값 (GPIO 번호, 단계표, 목표 조도, 안전)
│   ├── calib.py        # 단계별 실측값(lut.json) 읽기·쓰기
│   ├── storage.py      # SQLite 로그, CSV 내보내기
│   ├── control/        # 규칙 판단, 제어 루프, 단계 전환·안정화, 개인 선호 보정
│   ├── devices/        # 장치 인터페이스, 가짜 센서·릴레이, 실제 드라이버(BH1750, 릴레이)
│   ├── sim/            # 가상 시계, 바깥 빛 시뮬레이션
│   ├── ai/             # 학습 데이터, 결정트리 학습·추론, 규칙 대 AI 평가
│   ├── templates/, static/   # 대시보드 화면
│   ├── data/           # 학습된 모델(ai_tree.json), 실측값(lut.json)
│   ├── tests/          # pytest
│   └── tools/          # 센서·릴레이 확인 도구
├── deploy/             # Pi 설치 스크립트, 핫스팟, 자동 실행(systemd), 설치 안내서
├── tools/              # 기상청 일사량 → 조도 변환, 정량지표 계산
├── data/               # 기상청 ASOS 일사량 원본
├── hardware/           # 부품 목록, Pi 5 배선, 안전 점검표
├── docs/               # 정량지표 정의, 비교 그래프(images/), 6단계 기록(archive/), 트러블슈팅
├── server/ai/          # 초기 Arduino용 모델 학습 코드 (참고용)
└── firmware/           # 초기 Arduino Uno 프로토타입 (참고용)
```

## 진행 상황

- [x] 필름 2장 겹침 6단계 구조와 변압기·릴레이 구동 방식 확정
- [x] 기상청 일사량 → 조도 변환 도구, 정량지표 계산 스크립트
- [x] 장치 인터페이스와 가짜 장치, 가상 시계 시뮬레이터
- [x] 규칙 판단, 제어 루프, 안정화, 안전 전환 순서
- [x] 오프라인 웹 대시보드와 하루 압축 재생, SQLite 로그
- [x] AI 선제 차광 (결정트리), 규칙 대 AI 비교 (시뮬레이션)
- [x] 실측값 자동 반영 구조, 센서 고장 대비, 자동 테스트(163개 + 실제 드라이버 6개), 비교 그래프
- [x] Pi 5 센서 · 릴레이 드라이버
- [x] 필름 구동 전압(60~70V) 확인 후 45V 3단계 + 두 선 차단으로 전환 (6단계는 설정으로 선택)
- [x] 3단계 동작, 단계별 조도 실측 (11/1, 스탠드 2/5/7/8/10)
- [x] 실측 기준 재학습·재평가, 센서 잡음 대책(중앙값 평활·잡음 증강·AI 출력 데드밴드)
- [x] 센서·스탠드 위치 고정 후 재측정 (`lut.json`, 주간 목표 320 lux)
- [x] 개인 선호 보정 (사용자 프로필, 가상 사용자 검증)
- [x] 음성 명령: 의도 분류기 + Gemini 하이브리드, whisper.cpp 오프라인 음성 인식
- [x] Pi 핫스팟 배포, 휴대폰 앱 화면
- [x] 학술제 최종 시연 (Pi 핫스팟 + 휴대폰 앱·음성 명령), 순천향대학교 캡스톤 경진대회 장려상

## 한계와 향후 과제

- **필름의 차광 폭이 좁습니다.** 실측에서 가장 뿌연 단계도 빛의 약 68%를 통과시켜, 한낮 직사광에서는 0단계로도 목표 조도를 넘습니다. 그래서 가정값 시뮬레이션에서 보였던 AI 선제 차광의 눈부심 감소 효과(약 1/3)가 실측 투과율에서는 나오지 않았습니다. 차광 폭이 큰 필름이나 필름 추가가 필요합니다.
- **개인 선호 보정은 실측 투과율로 다시 검증하지 않았습니다.** 위 결과는 6단계 가정값 기준입니다.
- **Pi에서 whisper.cpp 인식 시간·정확도를 재지 못했습니다.** 시연에서는 동작했지만 정량 수치는 없습니다.
- **음성 분류기가 높은 확신으로 틀리는 문장 3개**는 예문 보강으로 고칠 수 있습니다.
- 실측은 실내 스탠드 조명 기준이라, 실제 창가의 햇빛으로는 검증하지 않았습니다.

## 설계하면서 내린 결정

- **트라이악 디머를 쓰지 않았습니다.** 위상 제어는 사인파를 잘라 내는 방식이라 PDLC 같은 용량성 부하에 맞지 않고, 필름 제조사도 권장하지 않았습니다. 정상 사인파를 그대로 쓰는 변압기 방식을 택했습니다.
- **상용 디밍 컨트롤러 대신 직접 구동했습니다.** 납기 문제로 상용 컨트롤러를 쓸 수 없게 되어, 필름 2장 겹침과 2단 변압기로 단계를 직접 설계했습니다. 단계 선택과 판단 로직이 모두 우리 소프트웨어 안에 있게 되었습니다.
- **필름을 겹쳐 단계를 늘렸습니다.** 한 장으로는 켜고 끄는 두 상태뿐이지만, 두 장을 겹치면 한 장만 켠 상태가 생겨 3단계가 됩니다(전압을 두 가지로 쓰면 6가지). 대신 가장 밝은 상태의 투명도는 한 장일 때보다 조금 낮아집니다.
- **100V를 빼고 45V 3단계로 줄였습니다.** 필름 업체가 구동 전압을 60~70V로 안내해, 100V는 필름 손상 위험이 있었습니다. 선택 릴레이가 필요 없어진 자리에 전원 릴레이를 하나씩 더 달아 필름의 두 선을 모두 끊도록 바꿨습니다. 변압기가 단권(입출력 비절연)이라, 꺼진 필름에 전압이 남지 않게 하는 것이 중요했습니다. 코드는 `LIGHTQ_LEVELS=6` 하나로 6단계로 돌아갈 수 있습니다. 원래 6단계 설계와 결과, 검토한 대안은 [트러블슈팅 기록](docs/troubleshooting-6-to-3-levels.md)에 남겼습니다.
- **메인 보드를 Raspberry Pi 5로 바꿨습니다.** 처음에는 Arduino Uno에서 모델을 C 코드로 돌릴 계획이었지만, 웹 대시보드와 학습·로그 기능까지 한 장치에서 처리하기 위해 Pi 5로 통일했습니다.
- **AI 모델로 결정트리를 골랐습니다.** 특징 6개짜리 작은 문제라 충분하고, 판단 근거를 설명할 수 있으며, Pi에서 무거운 라이브러리 없이 1ms 안에 추론됩니다.
- **안정화 조건을 '같은 값'에서 '같은 방향'으로 바꿨습니다.** AI는 직사광이 오를 때 후보가 2 → 1 → 2처럼 어둡게 가는 방향은 같지만 값이 흔들려, '같은 값 3회 연속' 조건에서는 오히려 늦게 반응했습니다. 비교 실험에서 발견해 고쳤습니다.
- **하드웨어 전에 시뮬레이터부터 만들었습니다.** 부품 도착 전에도 판단·웹·AI를 개발하고, 같은 조건에서 규칙과 AI를 공정하게 비교하기 위해서입니다.

## 안전

필름 구동부는 교류가 흐르고 변압기가 단권(입출력 비절연)이라, 변압기 뒤 모든 선을 220V로 취급합니다.

- 릴레이 접점과 연결부는 모두 절연 케이스 안에 두고 뚜껑을 닫은 뒤 전원을 넣습니다.
- 필름 연결 전 테스터로 변압기 출력 전압을 확인합니다 (T2 약 45V, 필름 구동 전압 60~70V 이하).
- 배선을 바꿀 때는 변압기 플러그를 뽑습니다.
- 소프트웨어: 전압 전환 때 전원 먼저 차단, 시작·종료 시 모든 릴레이 꺼짐, 센서 연속 10회 실패 시 0단계(전원 차단).

자세한 점검 항목은 `hardware/safety_checklist.md`에 있습니다.

## 협업 방식

- `main`은 항상 동작하는 상태로 유지하고, 기능은 `feature/`·`feat/`·`fix/` 브랜치에서 작업한 뒤 PR로 병합했습니다 (PR 27개).
- 커밋 메시지는 `[파트] 내용` 형식을 썼습니다. 예: `[pi] 릴레이 전환 순서 고정`
- PR 전에 `python -m pytest pi/tests -q`가 통과해야 병합했습니다.
