min-jx-x/microprocessor-capstone/hardware/README.md

# hardware

회로도, 배선도, 부품 리스트(BOM)를 관리합니다. 부품 리스트는 4주차 제안서 통과 후 발주에 바로 쓸 수 있게 표 형식으로 정리해두면 좋습니다.
