min-jx-x/microprocessor-capstone/docs/quantitative-metrics.md

# 정량지표 정의 (심사 체크포인트 ③)

제안서/결과보고서에 쓸 수치를 실측 기반으로 확정하기 위한 정의. 값 자체는 캘리브레이션 후 채워 넣는다.
(평가 및 측정 도구: `tools/metrics.py`, `tools/make_lut.py`, `tools/validate_csv.py`, `tools/convert_kma_radiation.py`)

## 제어 단계 기준 (3단계)

필름 2장 × (꺼짐 / 약 45V)로 3단계(0 ~ 2)를 제어한다. 필름 업체 안내 구동 전압(60~70V)에 맞춘 구성이다.
설정 `LIGHTQ_LEVELS=6`이면 100V를 더한 6단계(0 ~ 5)로 바뀐다.

| 단계 (Level) | 필름 A / B | 기본 투과율(LUT_T, 실측 전 가정값) | 주 시간대 / 비고 |
|---|---|---|---|
| 0 | 꺼짐 / 꺼짐 | 0.44 | 취침·저녁 고정, 가장 어두움 |
| 1 | 45V / 꺼짐 | 0.67 | |
| 2 | 45V / 45V | 1.00 | 가장 밝음 |

실측 후에는 `pi/data/lut.json` 값(가장 밝은 단계 = 1.0)으로 바뀐다. 시간대별 목표 조도는 `pi/config.py`를 따른다.

## 정확도 (Accuracy)

목표 조도(lux) 대비 실제 도달 조도의 오차율(%). 예: 목표 조도 설정 시 실측값이 허용 오차 범위(±10%) 안에 들어오는 비율.
- 측정/평가 방법: `tools/metrics.py` 실행
- 보조 지표: 평균 절대 백분율 오차 (MAPE, %)

## 오탐률 (False Positive Rate)

의도치 않게 단계가 잘못 전환되는 비율 (센서 노이즈, 급격한 외부광 변화 등으로 오작동하는 경우).
- 정의: 직전 상태가 목표 lux 오차 범위(±10%) 내에 안정적으로 유지되었음에도 불필요하게 단계를 변경한 비율.
- 측정/평가 방법: `tools/metrics.py`의 `fp_rate` 산출.

## 지연시간 (Latency)

센서가 조도 변화(임계값 이상의 lux 급변)를 감지한 시점부터 액추에이터(필름)가 반응을 완료(단계 전환)하기까지 걸리는 시간(초/ms).
- 측정/평가 방법: 조도 급변 발생 시점(타임스탬프)과 단계 전환 완료 시점 차이 평균 계산.

## 전시 시연 시나리오 (30초 목표)

1. (0~5초) 초기 상태: 특정 단계(예: 취침 0단계)로 세팅된 상태에서 시작
2. (5~15초) 조도 변화 트리거(조명 변경 또는 시간대 모드 전환 H08, H12 등) → 센서 감지
3. (15~25초) Pi 판단 → 필름을 최적 단계로 전환
4. (25~30초) 목표 조도 도달 확인 (관람객이 눈으로 확인 가능하게)
