min-jx-x/microprocessor-capstone/docs/roadmap.md

# 액추에이터(필름/파워서플라이) 확정 이후 로드맵

견적 문의(2026-09-28 발송) 답변 수신을 기준점으로 잡은 상세 실행 순서. 진행하면서 체크하고 갱신할 것.

## 오늘(2026-10-07) 역할 분담 시작 — 즉시 할 일

구매 완료, 전 부품 배송 중. 역할을 나눠 병행 진행.

- [ ] **(강민재) AI 레벨3(TinyML) 정의 재확인** — 교수님이 특정 보드는 지정하지 않음 → **우노 R3 그대로 유지, 추가 발주 불필요**로 판단.
  - 단, TensorFlow Lite Micro 등 정식 TinyML 프레임워크는 AVR(우노)을 지원하지 않는다는 하드웨어 제약이 있음 → "TinyML = 프레임워크 사용까지 요구"인지, "칩 안에서 추론 실행"이면 충분한지 교수님께 확인
  - 확인되면 `server/ai/train.py`(결정트리 → 순수 C 코드 내보내기, 프레임워크 미사용) 방식을 그대로 레벨3 구현으로 확정
  - "시계열 모델"은 LSTM 대신 **시차(lag) 특성을 포함한 작은 결정트리**로 구현(우노 SRAM 2KB 제약) — 이 절충안도 교수님께 설명 준비
- [x] TEAM PDLC 디밍 컨트롤러 버튼 레이아웃 확인 완료 (2026-10-07) — **개별 버튼 4개** (순환식 아님). `actuator.h`의 `ACTUATOR_RELAY_BUTTON` 모드로 반영함.
- [ ] (곽재우) 릴레이 모듈 3개 추가 발주 (1채널→4채널 필요, `hardware/bom.md` 참고) — 오늘 중
- [ ] (곽재우) TEAM PDLC/컨트롤러 실물에서 버튼 접점에 외부 배선(릴레이) 가능한 구조인지 확인 — 버튼이 리모컨(배터리, 저전압)인지 패널 직결(어떤 전압대인지)인지부터 확인
- [ ] (강민재) `pip install -r server/requirements-ai.txt`(numpy, scikit-learn — LSTM 프레임워크는 불필요, 결정트리+시차 특성으로 충분), `generate_synthetic.py`를 시계열(하루 단위 시퀀스) 생성 방식으로 재설계 시작
- [ ] (김대현) `g++` 설치 후 `firmware/host_tests/test_decision.cpp` 통과 확인, `actuator.h`에 릴레이-버튼 시뮬레이션 모드(`ACTUATOR_RELAY_BUTTON`) 추가
- [ ] (전원) `feature/기능명` 브랜치 생성 후 각자 이름으로 커밋 쌓기 시작 (개인 기여도 평가 대비)
- [ ] 8주차 프로토타입 시연 정확한 날짜 확정 → 역산해서 데이터 수집/캘리브레이션 일정 잡기

## Phase 0. 견적 답변 도착 직후 — 구매 전 판단

- [x] **필름 소싱처는 TEAM PDLC로 확정** (2026-09-29). 근거: 전압/주파수/소비전력/단계방식/단품구매여부/가격에 필요한 정보를 전부 답변, 4주차 게이트 일정상 추가 대기 실익 적음. 상세는 `docs/actuator-control-notes.md` "진행 현황" 참고.
- [ ] 파워서플라이/컨트롤러는 별개로 여전히 미확정 — yjsystems 등에 문의 발송 완료(2026-09-29), 답변 대기 중 (필름 확정이 방식 2 vs 방식 4 선택을 자동으로 정하지 않음)
- [ ] 국내 3곳(TEAM PDLC, 필름베이스코리아, PDLC코리아) + pdlcglass.com 답변을 표로 정리 (사이즈별 가격, 전압, 디밍 여부, 외부제어 인터페이스, 투과율, 반응속도, 배송기간, MOQ, AS) — 파워서플라이 쪽 비교에 한해 계속 진행
- [ ] 필수조건 4가지(① PDLC 전용/정현파 ② 실제 디밍 기능 ③ 0-10V 또는 RS485 외부제어 단자 ④ 파워서플라이 출력전압=필름 정격전압) 충족 여부로 후보 스크리닝
- [ ] 분기 결정
  - (A) 국내 한 곳에서 필름+파워서플라이 세트로 조건 충족 → 그 업체로 단일 구매 확정 (제일 간단, 우선순위 1순위)
  - (B) 국내 필름은 조건 충족하는데 파워서플라이만 부족 → 필름은 국내에서, 파워서플라이는 pdlcglass.com(또는 다른 곳)에서 별도 구매 — 이 경우 전압 재확인 필수
  - (C) 어디서도 조건 충족 안 됨 → 방식 4(DIY 다단 변압기+릴레이)로 전환, `docs/actuator-control-notes.md` 방식4 기준으로 부품 재산정
- [ ] 4주차 제안서 심사 통과 여부 재확인 — 통과 전이면 결제는 보류하고 여기까지만 진행
- [ ] **확인 필요**: 실제 설치할 창문/블라인드 정확한 실측 사이즈 — 현재는 목표 범위(가로 50~60cm × 세로 150~180cm)의 중간값인 60cm×170cm(약 1.02㎡)를 작업 기준으로 임시 채택한 상태, 실측 나오는 대로 TEAM PDLC 발주 사이즈 갱신

## Phase 1. 1차 구매 (확정 즉시)

- [ ] A4(또는 유사 소형) 데모 필름 + 매칭 파워서플라이(가능하면 같은 세트) 발주
- [ ] 제어 방식이 확정됐다면 그에 맞는 추가 모듈도 동시에 발주
  - 0-10V 방식 → PWM-to-0-10V 변환 모듈
  - RS485 방식 → MAX485(TTL-RS485) 모듈
  - 방식 4(DIY) → 소형 트랜스포머 여러 개 + 릴레이 모듈(다채널)
- [ ] (병행, 언제 사도 무방) 공통 부품 발주: BH1750(GY-302), 아두이노 우노 R3, ESP8266 NodeMCU, 점퍼선/브레드보드 또는 만능기판, 절연 하우징 자재
- [ ] 팀원별 구매 담당/영수증 보관 — 지출 기록은 나중에 결과보고서 예산 항목에 필요

## Phase 2. 배송 대기 기간 — 상품 도착 전까지 할 일 (병행 작업)

필름/파워서플라이가 오기 전에도 진행 가능한 작업들. 이 기간을 놀리지 않는 게 일정(8주차 프로토타입 게이트) 관리의 핵심.

- [ ] `firmware/sketches/dimming_control_v1/dimming_control_v1.ino`의 TODO 순차 구현
  - BH1750 라이브러리 연동 (Wire.h + BH1750.h) — 센서만 있으면 바로 가능
  - 시간대 판단 로직 뼈대 (ESP8266 NTP 또는 RTC) 작성
  - `controlActuator()`를 확정된 제어 방식에 맞게 미리 구현 (필름 없이 시리얼 출력으로 로직만 먼저 검증 가능)
- [ ] BH1750 + 아두이노 + ESP8266 도착하는 대로 센서-MCU-Wi-Fi 통신 배선/테스트 먼저 진행 (필름 없이도 가능한 부분부터 진행해서 대기시간 최소화)
- [ ] 안전 하우징/절연 설계 확정 — AC 220V 구간 밀폐 방식 구체화, 케이스 자재 있으면 미리 준비
- [ ] `docs/quantitative-metrics.md`의 정확도/오탐률/지연시간 측정 절차를 실제 실험 프로토콜(측정 타이밍, 로깅 코드)로 구체화
- [ ] 팀 역할 분담 확정 및 `feature/기능명` 브랜치 생성 — 배선 담당, 소프트웨어 담당, 문서화 담당 나눠서 커밋 기록에 반영(개인 기여도 평가 대비)
- [ ] 결과보고서용 안전조치 문서 초안 작성

## Phase 3. 필름/파워서플라이 도착 후

- [ ] 개봉 검수 — 파손 여부, 견적서 스펙(전압 등)과 실물 일치 여부 확인
- [ ] 안전 하우징/절연 처리 먼저 완료한 뒤 배선 (AC 구간 노출 금지)
- [ ] 기본 동작 테스트 — 전원 인가 후 필름이 실제로 투명↔불투명 반응하는지 확인
- [ ] 전압(또는 제어값)별 투과율 실측 (BH1750) → `calibrationTable` 채우기 → 룩업테이블 완성
- [ ] `controlActuator()`를 실제 필름에 연결해 통합 동작 확인
- [ ] `docs/quantitative-metrics.md`의 정확도·오탐률·지연시간 실측치 채우기

## Phase 4. 통합 및 게이트 대비

- [ ] 센서 → MCU 판단 → 액추에이터 전체 루프 통합 테스트
- [ ] 8주차 프로토타입 시연 시나리오(30초, `quantitative-metrics.md` 참고) 리허설
- [ ] 미비점 보완 후 재시연 대비

## Phase 5. 15주차 최종 시연까지

- [ ] 브랜치/커밋 규칙(`[파트] 내용`) 준수하며 기능 고도화
- [ ] 최종 발표자료·결과보고서에 안전조치·정량지표 결과 반영
