min-jx-x/microprocessor-capstone/docs/actuator-control-notes.md

# 액추에이터(조광 필름) 제어 방식 — 검토 기록

부품 발주 전에 반드시 확인해야 하는 리스크. 지원금이 나오기 전까지는 이 문서를 기준으로 논의를 이어가고, 확정되는 대로 갱신한다.

## 배경

목표: PDLC(또는 전기변색) 조광 필름을 아두이노로 여러 단계(또는 연속)로 밝기 조절.

## 검토한 방식과 결론

### 1. 프리셋 버튼 컨트롤러 (상용 "4단계" 제품, 약 25만원대)
- 원리(추정): 트랜스포머에 전압이 다른 탭을 여러 개 두고 버튼/릴레이로 탭을 전환. 정현파 유지.
- 장점: 실제 판매 제품 확인됨, 회로 단순(릴레이로 버튼 시뮬레이션).
- 단점: 하드웨어에 고정된 단계 수(4개)만 가능. 정확한 단계별 투과율(%)은 스펙시트에 없어 판매자 문의 필요.

### 2. 0-10V 연속 디밍 + PWM-to-0-10V 변환 모듈
- 원리: PDLC 전용 파워서플라이가 0-10V 아날로그 제어 신호를 받아 내부적으로 안전하게 AC를 생성. 아두이노는 PWM→0-10V 변환 모듈을 거쳐 저전압 신호만 보냄 (AC 쪽은 손대지 않음).
- 실제 상용 제품 확인: [pdlcglass.com Dimmer Control Power Adapter](https://www.pdlcglass.com/products/dimmer-control-power-adapter/) — AC 0~60V, 50/100/200W, 벽스위치/리모컨/RS485/앱 제어 지원.
- 장점: 정현파 왜곡 문제 없음(파형 생성은 파워서플라이 내부 회로가 담당). 이론상 연속 제어 가능.
- 단점(확인 필요): 국내 소량구매·배송 가능 여부 미확인 (해외 B2B 사이트 기준 조사됨). 필름 자체의 전압-투과율 관계가 선형이라는 보장은 없음 — 실측 캘리브레이션 필요.

### 3. 트라이악(TRIAC) 위상제어 AC 디머 모듈 — 비권장으로 잠정 결론
- 원리: 아두이노가 AC 파형의 위상각을 직접 잘라서(phase-cut) 실효전압을 조절. RobotDyn류 모듈, 국내 다나와에서 2.7만원대부터 실구매 확인됨.
- **리스크**: 전자공학 포럼([edaboard.com 스레드](https://www.edaboard.com/threads/pdlc-smart-glass-power-supply.401025/)) 전문가 의견 — "TRIAC 기반 공급은 TRIAC를 ON/OFF 스위치로만 쓰지 않는 이상 정현파를 출력하지 않는다." PDLC/전기변색 소재는 파형 왜곡에 민감할 수 있어(깜빡임, 불완전한 반응) 백열등/LED용으로 설계된 이 부품이 PDLC엔 안 맞을 가능성이 있음.
- 포럼에서 제시한 대안: 오토트랜스포머(Variac, 수동/모터구동), 다단 변압기 탭 전환(방식 1과 동일 원리), 저항강하 회로(비효율적).
- **결론**: 이 방식은 채택하지 않는 걸로 잠정 결론. 소프트웨어로 세밀하게 제어하고 싶으면 방식 2(정식 0-10V 파워서플라이) 또는 방식 4(DIY 다단 변압기)로.

### 4. DIY 다단 변압기 조합 + 릴레이 (대안, 국내 부품으로 구현 가능)
- 원리: 서로 다른 전압을 내는 소형 트랜스포머 여러 개를 릴레이로 조합. 예: 트랜스포머 3개를 이진조합하면 2³=8단계 구현 가능.
- 장점: 정현파 유지, 국내에서 쉽게 구할 수 있는 부품만 사용, 소프트웨어(릴레이 ON/OFF 조합)로 단계 수 결정.
- 단점: 방식 1보다 회로/배선이 복잡함(직접 설계 필요).

## 남은 결정 사항

- [ ] 방식 2(0-10V 정식 파워서플라이) 국내 소싱 가능 여부 확인
- [ ] 방식 2 vs 방식 4 최종 선택
- [ ] 어느 방식이든: 저가 A4 PDLC 데모 필름으로 먼저 실물 반응 테스트 (부품 대량구매 전 리스크 검증)
- [ ] 전압(또는 탭/릴레이 조합)별 실측 투과율(BH1750) 캘리브레이션 → 룩업테이블 구성 → 정량지표(정확도) 근거로 사용

## 안전 주의사항

AC 220V가 지나가는 구간(파워서플라이 입력단, 트랜스포머/릴레이 배선)은 절연 하우징 처리 필수. 전시 시연 때 관람객 손이 닿지 않게 밀폐. 결과보고서에 안전 조치 명시.
