min-jx-x/microprocessor-capstone/firmware/README.md

# firmware

아두이노 우노(ATmega328P) 스케치 코드. 센서 읽기, 인터럽트 처리, 서버와의 통신, 액추에이터 제어를 담당합니다.

`sketches/` 아래에 스케치별 폴더를 만들어 관리하세요 (예: `sketches/seat_sensor_v1/seat_sensor_v1.ino`).
