min-jx-x/microprocessor-capstone/server/README.md

# server

백엔드, AI 판단 로직(클라우드 API 연동), 웹/앱 클라이언트 코드. 팀이 소프트웨어 중심으로 프로젝트를 설계했다면 대부분의 로직이 여기 들어갑니다.
