min-jx-x/microprocessor-capstone/pi/requirements-ai.txt

# 노트북에서 AI 학습할 때만 필요 (Pi에는 설치 안 해도 됨)
numpy
scikit-learn
matplotlib
