min-jx-x/microprocessor-capstone/tools/validate_csv.py

"""수집한 로그 CSV(ms,hour,lux,level)를 점검한다. (표준 라이브러리만 사용)

사용법:
    python tools/validate_csv.py data/raw/log_xxx.csv [--levels 3]   (기본: LIGHTQ_LEVELS, 없으면 3)
"""
import argparse
import csv
import os
import statistics
import sys


def main():
    default_levels = 6 if os.environ.get("LIGHTQ_LEVELS", "").strip() == "6" else 3   # pi/calib.py와 같은 규칙
    ap = argparse.ArgumentParser(description=f"수집 로그 CSV 유효성 점검 (기본 {default_levels}단계: 0~{default_levels - 1})")
    ap.add_argument("path", help="검증할 로그 CSV 파일 경로")
    ap.add_argument("--levels", type=int, default=default_levels, help=f"단계 수 (pi/config.py 의 NUM_LEVELS, 기본값: {default_levels})")
    args = ap.parse_args()

    problems, rows = [], []
    with open(args.path, newline="", encoding="utf-8") as f:
        reader = csv.DictReader(f)
        expected = ["ms", "hour", "lux", "level"]
        if reader.fieldnames != expected:
            print(f"헤더가 다름: {reader.fieldnames} (기대: {expected})")
            sys.exit(1)
        for i, r in enumerate(reader, start=2):
            try:
                ms, hour, lux, level = int(r["ms"]), int(r["hour"]), float(r["lux"]), int(r["level"])
            except (ValueError, TypeError):
                problems.append(f"line {i}: 숫자 변환 실패 {r}")
                continue
            if not 0 <= hour <= 23:
                problems.append(f"line {i}: hour 범위 밖 {hour}")
            if not 0 <= lux <= 100000:
                problems.append(f"line {i}: lux 이상값 {lux}")
            if not 0 <= level < args.levels:
                problems.append(f"line {i}: level 범위 밖 {level} (0~{args.levels - 1})")
            rows.append((ms, hour, lux, level))

    if not rows:
        print("유효한 행이 없음")
        sys.exit(1)

    gaps = [b[0] - a[0] for a, b in zip(rows, rows[1:])]
    if any(g <= 0 for g in gaps):
        problems.append("ms가 증가하지 않는 구간이 있음 (보드 재시작 가능성)")
    pos = [g for g in gaps if g > 0]
    if pos:
        med = statistics.median(pos)
        big = [g for g in pos if g > 5 * med]
        if big:
            problems.append(f"측정 간격이 중앙값({med}ms)의 5배 넘는 구간 {len(big)}곳 (끊김 가능성)")

    luxes = [r[2] for r in rows]
    print(f"행 수: {len(rows)}")
    print(f"lux 최소/중앙/최대: {min(luxes):.1f} / {statistics.median(luxes):.1f} / {max(luxes):.1f}")
    counts = {lv: sum(1 for r in rows if r[3] == lv) for lv in range(args.levels)}
    print(f"단계별 행 수: {counts}")
    print(f"hour 분포: {sorted(set(r[1] for r in rows))}")
    if problems:
        print(f"\n문제 {len(problems)}건 (최대 20건 표시):")
        for p in problems[:20]:
            print(" -", p)
        sys.exit(2)
    print("\n문제 없음")


if __name__ == "__main__":
    main()
