min-jx-x/microprocessor-capstone/pi/devices/sim.py

"""노트북용 가짜 장치.

SimRelays: 릴레이 상태를 메모리에만 저장한다.
SimSensor: 바깥 빛 × 필름 투과율 + 실내 잡광 + 잡음으로 조도를 계산한다.
           필름 상태는 SimRelays의 현재 릴레이 상태에서 읽는다.
"""
import random
from typing import Callable, Dict, Optional

from pi import calib, config

# 필름 한 장의 상태별 투과율 (가정값).
# 실측(pi/tools/calibrate.py) 후 pi/data/lut.json 값으로 바꾼다.
# 두 장을 겹치면 투과율이 곱해진다. 예: high + low = 0.8 * 0.45 = 0.36
FILM_T = {"off": 0.30, "low": 0.45, "high": 0.80}
# 가장 밝은 단계의 절대 투과율 (실측은 상대값뿐이라 이 값으로 크기를 맞춤). 3단계 = 45V/45V, 6단계 = 100V/100V
SIM_T_TOP = max(FILM_T[a] * FILM_T[b] for a, b in calib.DEFAULT_LEVELS)


def combo_transmittance(a: str, b: str) -> float:
    """필름 조합의 투과율. 실측 lut.json이 있으면 실측 상대값 × SIM_T_TOP, 없으면 가정값의 곱."""
    if config.CALIBRATION is not None and (a, b) in config.LEVELS:
        return SIM_T_TOP * config.LUT_T[config.LEVELS.index((a, b))]
    return FILM_T[a] * FILM_T[b]


def level_transmittance(level: int) -> float:
    return combo_transmittance(*config.LEVELS[level])


def default_ambient() -> float:
    """실측 때 잰 실내 잡광이 있으면 그 값, 없으면 5 lux."""
    cal = config.CALIBRATION
    return cal.ambient if cal is not None and cal.ambient > 0 else 5.0


class SimRelays:
    def __init__(self) -> None:
        self.state: Dict[str, bool] = {name: False for name in config.GPIO_PINS}
        self.history = []  # (이름, on) 순서 기록. 전환 순서 테스트에 쓴다.

    def set(self, name: str, on: bool) -> None:
        if name not in self.state:
            raise KeyError(f"모르는 릴레이 이름: {name}")
        self.state[name] = on
        self.history.append((name, on))

    def all_off(self) -> None:
        for name in self.state:
            self.set(name, False)

    def close(self) -> None:
        self.all_off()

    def film_states(self) -> tuple:
        """릴레이 상태로부터 (필름 A 상태, 필름 B 상태)를 계산한다."""
        def one(sel: str, power: str) -> str:
            if not self.state[power]:
                return "off"
            return "high" if self.state[sel] else "low"
        return one("SA", "PA"), one("SB", "PB")


class SimSensor:
    def __init__(self, relays: SimRelays, outdoor_lux: Callable[[], float],
                 ambient_lux: Optional[float] = None, noise: float = 0.02,
                 seed: Optional[int] = None) -> None:
        """
        relays      : 필름 상태를 읽어 올 SimRelays
        outdoor_lux : 필름에 닿는 바깥 빛(lux)을 돌려주는 함수 (시나리오가 제공)
        ambient_lux : 필름과 무관한 실내 잡광
        noise       : 측정 잡음 비율 (0.02 = ±2%)
        """
        self.relays = relays
        self.outdoor_lux = outdoor_lux
        self.ambient_lux = default_ambient() if ambient_lux is None else ambient_lux
        self.noise = noise
        self.rng = random.Random(seed)

    def transmittance(self) -> float:
        return combo_transmittance(*self.relays.film_states())

    def read_lux(self) -> Optional[float]:
        lux = self.outdoor_lux() * self.transmittance() + self.ambient_lux
        lux *= 1.0 + self.rng.uniform(-self.noise, self.noise)
        return round(max(lux, 0.0), 1)

    def close(self) -> None:
        pass
