min-jx-x/microprocessor-capstone/(commit log)

2026-09-03 docs: 레포명·팀원 정보 업데이트
2026-09-21 docs: 프로젝트 확정 반영 및 초기 스켈레톤 추가
2026-09-28 액추에이터/BOM 검토 반영, 로드맵 및 firmware 테스트 가이드 추가
2026-09-30 [docs] 필름 소싱처 TEAM PDLC 확정, 문의 발송 현황, 디바이스마트 구매 리스트 반영
    - 필름(TEAM PDLC) 확정 근거 및 사이즈(60x170cm) 임시 기준 기록
    - 파워서플라이/컨트롤러(yjsystems 등) 문의 발송 완료 상태 반영
    - 디바이스마트 장바구니(BH1750/릴레이/ESP8266) 상품코드·가격·구매링크 정리, 아두이노는 기존 보유분 사용 확인
    Claude-Session: https://claude.ai/code/session_01BcgpqeQb7PAhNSNozYinxi
2026-09-30 [docs] TEAM PDLC 필름 스펙 확정 및 YJ SYSTEMS 컨트롤러 호환성 검토
    - 필름 구동 스펙 확정: AC 60V/60Hz, 단계식 디밍(4단계), RS485/0-10V 미지원
    - TEAM PDLC 번들 컨트롤러는 MCU 자동제어 불가 확인 -> 채택 불가 결론
    - YJ SYSTEMS 컨트롤러 스펙과 대조 표 추가, 전압/주파수 일치 확인
    - bom.md 필름 가격을 확정가(1㎡당 20만원)로 갱신
    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
2026-10-07 [docs] 액추에이터 제어 노트 보완
2026-10-07 feat: 펌웨어, AI, 하드웨어 기본 구조 추가
2026-10-11 [firmware] PDLC 컨트롤러 버튼 릴레이 제어 모드 추가, 4단계로 변경
    - actuator.h: ACTUATOR_RELAY_BUTTON 모드 추가 (프리셋 버튼 4개를 릴레이 펄스로 누름), 기본 모드로 설정
    - params.h: NUM_LEVELS 5 -> 4, LUT_T를 TEAM PDLC 프리셋 투과율(7/15/30/100%)로 갱신
2026-10-11 [docs] AI 레벨3(TinyML) 확정, 릴레이 4채널 배선·발주 반영
    - README/team_interface: AI 레벨3 확정, 합성 시계열 데이터 + lag 특성 결정트리 방침
    - roadmap: 2026-10-07 역할 분담 즉시 할 일 추가
    - bom/wiring: 릴레이 4채널(D4~D7) 배선, 3채널 추가 발주 필요 명시
2026-10-11 [hardware] 릴레이 시험·캘리브레이션 도구를 4단계 기준으로 맞춤
    - relay_test.ino: 릴레이 핀 5개 -> 4개 (D4~D7)
    - make_lut.py, validate_csv.py: --levels 기본값 5 -> 4
2026-10-13 [tools] docs 사양에 맞춘 정량지표 계산 metrics.py 구현
2026-10-22 [tools] 기상청 일사량 환산 도구 추가 및 metrics 정량지표 평가 고도화
    - data/OBS_ASOS_TIM_20261022222346.csv: 기상청 충남(서산/홍성/보령) 시별 일사량 관측 원본 추가
    - data/sample_log.csv: 홍성(177) 일사량을 태양광 발광효율(116 lm/W) 기준으로 lux 환산 반영
    - tools/convert_kma_radiation.py: 기상청 ASOS CSV를 목표 조도 제어 단계와 함께 변환하는 스크립트 구현
    - tools/metrics.py: params.h(4단계, 시간대별 목표) 자동 연동, 야외 입사광/실내 센서 모드 지원 및 MAPE 추가
2026-10-24 [docs] README를 프로젝트 소개 형식으로 전면 개편
2026-10-24 [pi] Pi 5 코드 기본 구조와 설정 파일 추가
2026-10-24 [pi] 노트북용 가짜 센서·릴레이와 가상 시계, 바깥 빛 시뮬레이션 추가
2026-10-24 [pi] Flask 웹 대시보드와 규칙 판단·제어 루프·로그 추가
2026-10-24 [pi] 결정트리 AI 판단과 선제 차광, 규칙 대 AI 비교 추가
2026-10-24 [pi] 실측 LUT 자동 반영, 재학습 명령, 실물 시연 모드, 센서 고장 대비, 자동 테스트 추가
2026-10-24 [docs] README에 AI 선제 차광, 정량 평가 결과, 실행·실측 절차 추가
2026-10-24 [pi] 안정화 조건을 같은 방향 기준으로 개선, 재학습, 규칙 대 AI 비교 그래프 추가
2026-10-24 [docs] README 결과 갱신, 오래된 문서 삭제, 부품 목록과 Pi 5 배선 문서 정리
2026-10-24 [pi] Pi 5 설치·핫스팟·자동 실행 스크립트와 센서·릴레이 시험 도구 추가
2026-10-24 [pi] 개인 선호 보정(사용자 프로필·온라인 학습)과 가상 사용자 검증 추가
2026-10-26 [pi] BH1750 조도센서·GPIO 릴레이 드라이버, 안전 단계 전환기 및 안정화기 구현
2026-10-26 [pi] BH1750 센서 구현 위치를 bh1750.py로 정리
2026-10-27 [tools] 최신 main 반영: 6단계 조도 실측 도구 및 pi/config 연동 정량지표 평가
    - pi/tools/calibrate.py: 0~5단계 3초 안정화 조도 실측 및 pi/data/lut.json 생성 도구 구현
    - pi/calib.py: 6단계 조합 순서(꺼짐/45V/100V) 기반 실측 및 ratio 자동 산출
    - tools/metrics.py: pi/config.py(6단계, 목표 조도) 및 lut.json 연동 정량지표 평가 갱신
    - tools/make_lut.py, validate_csv.py: 6단계(0~5) 기본값 적용
    - docs/quantitative-metrics.md: 6단계 기준 정량평가 지표 사양 정리
2026-10-27 [tools] calibrate.py 인코딩 호환성 개선 ([경고] 표기) 및 테스트 검증 반영
2026-10-28 [pi] 실측 전 임시 lut.json 삭제
    pi/data/lut.json의 값(40/110/230/300/450/640 lux)은 pi/calib.py 설명의 예시와 같은 임시값인데,
    파일이 있으면 config.py가 실측값으로 처리해(LUT_SOURCE=measured) 판단 규칙·시뮬레이터·
    AI 재학습·정량지표가 모두 이 값을 쓰고 있었다. 하드웨어 실측 전까지는 기본 가정값(LUT_T_DEFAULT)을 쓰도록 삭제한다.
2026-10-28 [Fix] BH1750 센서 초기화 예외 처리 및 재시도 대기 시간 추가
    - 센서 미연결 상태 부팅 시 웹 서버 다운 방지 (self.bus = None 세팅)
    - read_lux 재시도 사이 0.05초 대기 로직 추가
2026-10-28 [pi] 웹 대시보드 개편
2026-10-28 [Fix] 하드웨어 연결 전 코드 점검 수정 (#13)
    * [Fix] 캘리브레이션을 단계 번호 대신 필름 조합으로 측정, 잡광 측정 추가
    lut.json이 있으면 config.LEVELS가 실측 밝기 순으로 바뀌어 다시 측정할 때 조합이 어긋나던 문제 수정.
    calib.save의 ratio를 잡광을 뺀 실제 사용값과 같게 저장.
    * [Fix] BH1750 초기화·읽기 실패 후 자동 재연결
    부팅 때 한 번 실패하면 재시작 전까지 계속 None을 반환하던 문제 수정. 연결 상태가 바뀔 때만 로그를 남김.
    * [Fix] AI 모델이 실측값과 맞지 않으면 규칙 판단으로 시작
    stale 검사에 단계 순서(levels) 비교도 추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
2026-10-28 [Fix] PA/PB 릴레이 극성 반전 및 RELAY_ACTIVE_LOW 설정 변경 (#14)
    - PA, PB 릴레이 신호만 반대로 동작하는 문제 수정 (relays.py)
    - config.py의 RELAY_ACTIVE_LOW = False 수정
2026-10-29 [pi] 45V 3단계 모드 전환 및 6단계 설계·모델 보관
2026-10-29 [pi] 3단계 결과·그래프 반영 및 6단계 결과 트러블슈팅 보관
    - README 정량 평가·모델 시험 결과를 3단계 기준으로 교체, 선호 보정은 6단계 기준 명시
    - docs/images 비교 그래프 3단계로 재생성 (선호 보정 그래프는 3단계에서 효과 없어 제거)
    - 트러블슈팅 문서에 6단계·3단계 직사광·모델 시험·선호 보정 비교 추가
    - plot_compare 단계 축을 NUM_LEVELS에 맞춤, 대표 장면을 평균에 가까운 seed로
    - 안전 점검표에 단권 변압기·누전차단기·두 선 차단 확인 추가
    - tools/metrics.py, validate_csv.py 기본 단계 수를 LIGHTQ_LEVELS에 맞춤
2026-10-29 [Fix] 릴레이별 극성 설정 및 부팅 중 PA/PB 켜짐 수정
    - RELAY_ACTIVE_LOW를 릴레이별 값으로 변경 (PA·PB만 저레벨 트리거, #14 결과)
    - setup_pi.sh가 부팅 레벨을 릴레이별로 기록 (gpio=27,23=op,dh / gpio=17,22=op,dl)
    기존에는 dl 한 줄이라 부팅 중 PA·PB가 켜져 필름에 전압이 걸렸음
    - 실제 드라이버 테스트를 릴레이별 극성 기준으로 수정, 부팅 레벨 검사 테스트 추가
    - 배선·배포 문서에 릴레이별 극성과 PA2·PB2 같은 타입 확인 안내 추가
2026-10-29 [pi] AI 설명 페이지와 모델 선택 근거 실험 추가 (#18)
2026-10-29 [Fix] 릴레이 4개 모두 고레벨 트리거로 극성 설정 수정 (#19)
2026-10-31 [pi] 음성 명령 하이브리드 제어 추가
    * [pi] 음성 명령 하이브리드 제어 추가 (의도 분류기 + Gemini)
    * [pi] 음성 LLM 시간 제한 5초로 변경, 하이브리드 평가 결과 추가
2026-10-31 [pi] whisper.cpp 오프라인 음성 인식, HTTPS 마이크, 상황형 예문 보강
    * [pi] whisper.cpp 오프라인 음성 인식, HTTPS 마이크, 상황형 예문 보강
    * [pi] 음성 녹음 첫 글자 잘림 수정, whisper 단어 보강
2026-11-01 [pi] 음성 명령 시연 전 수정: 기록 lock 분리, 프롬프트 반복 거르기, 8초 자동 종료 안내 (#22)
    * [pi] 음성 기록 lock 분리: LLM 처리 중에도 대시보드가 멈추지 않게
    * [pi] whisper가 프롬프트 문장을 지어낸 결과 거르기
    * [pi] 녹음 8초 자동 종료 때 버튼 되돌리고 안내, 중복 전송 막기
    * [pi] README 테스트 개수·드라이버 상태·음성 명령 진행 상황 정리
2026-11-01 [음성] whisper가 음악·잡음에서 명령 문장을 지어내는 문제 수정 (#23)
    * [음성] whisper식 표기·잡음 단어 예문 추가 후 의도 분류기 재학습
    * [음성] 음악·잡음 구간 버리기(verbose_json no_speech_prob·avg_logprob), 인식 프롬프트를 어휘만으로 축소
    * [음성] setup_whisper.sh에 Silero VAD 옵션 추가(기본 끔), 잡음 판정 문서화
    * [음성] README 테스트 개수 갱신
    * [음성] 노래에서 지어낸 '사생활' 대응: 인식 프롬프트에서 단어 제거, logprob 기준 -1.0 → -0.4
    Pi 재측정에서 노래만 틀었을 때 '사생활'(privacy 0.82, logprob -0.436)이 나와 실행될 뻔함.
    실제 명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
2026-11-01 [제어] 11/1 실측 반영: lut.json, 주간 목표 330 lux, 시연 기본 판단 규칙 (#24)
    * [제어] 11/1 실측 lut.json 반영, 주간 목표 500 → 320 lux
    - pi/data/lut.json: 스탠드 10, 잡광 140 lux (0.6473 / 0.7563 / 1.0)
    - TARGET_DAY_LUX 320: 290~340이면 스탠드 2·5 → 2단계, 10 → 0단계로 시작 단계와 무관하게 수렴
    - 테스트: 실측 lux로 decide_rule 반복 적용 시 수렴 단계 확인 (시작 0/1/2)
    * [제어] 실측 투과율로 AI 재학습, 비교 그래프 다시 생성
    * [제어] README에 11/1 실측표(스탠드 2/5/10) 추가
    * [제어] 주간 목표 330 lux, 시연 순서(스탠드 2→10→7→2) 수렴 테스트 추가
    - TARGET_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
2026-11-01 [AI] 센서 잡음 대책과 고정 후 재측정 반영: 중앙값 평활, 잡음 증강, AI 출력 데드밴드, 목표 320 lux (#25)
    * [제어] 센서 중앙값 평활, 디바운스 설정 이름, 시연 기본 판단 AI
    - SENSOR_MEDIAN_N = 5: 최근 5회(지금 단계에서 잰 값만) 중앙값으로 판단 (규칙·AI 공통, pi/control/filter.py)
    화면·기록에는 실제 측정값, info.lux_in에 판단에 쓴 값
    - SWITCH_CONFIRM_N = 3: 기존 안정화(같은 방향 3회 연속) 횟수의 이름. 수동·음성은 그대로 즉시 적용
    - AI_DEADBAND = "brighter" 설정 추가 (AI 출력 데드밴드, 구현은 [AI] 커밋)
    - LIGHTQ_POLICY 기본값 rule → ai. rule로 바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
2026-11-02 [웹] 휴대폰 전용 앱 화면 /app (홈·음성·설정), 음성 녹음 공통화, 시연 잠금 (#26)
    - /app: 홈(조도, 창문 그림, 0/1/2, 자동 스위치) / 음성(누르고 말하기, 예시 칩, 글자로 입력) / 설정(기상 시간, 선호 밝기, 학습 스위치) 탭. 휴대폰 전용, 노트북은 대시보드로
    - 녹음 공통 코드 voice-rec.js, 기기 이름 자동 ('아이폰 1')
    - 노트북 대시보드에서 음성 카드와 음성·앱 버튼 제거
    - 시연 잠금 LIGHTQ_DEMO_LOCK=1: 선호 밝기·사용자·학습 스위치 변경 403
    - Pi·아이폰 13 확인 완료
2026-11-09 [문서] 프로젝트 마무리: 학술제 시연·장려상 반영, 한계와 향후 과제 (#27)
    * [문서] 프로젝트 마무리: 학술제 시연·장려상 반영, 한계와 향후 과제 추가, 테스트 개수 갱신
    * [문서] README 맨 위에 핵심 성과 3줄 추가
2026-11-13 docs: 수상 내역을 상장 기준으로 정정 (#28)
    docs: 수상 내역을 상장 기준으로 정정 (공과대학 학술제 장려상)
    README의 수상 표기를 '캡스톤 경진대회 장려상'에서 상장 기준인
    '제35회 순천향대학교 공과대학 학술제 장려상(2026.11.04)'으로 수정.
    Claude-Session: https://claude.ai/code/session_017Phtss1H1Xx57n9XrVdC87
